icewtr/DraftONE/Wiring/Draft wiring diagram.jpg

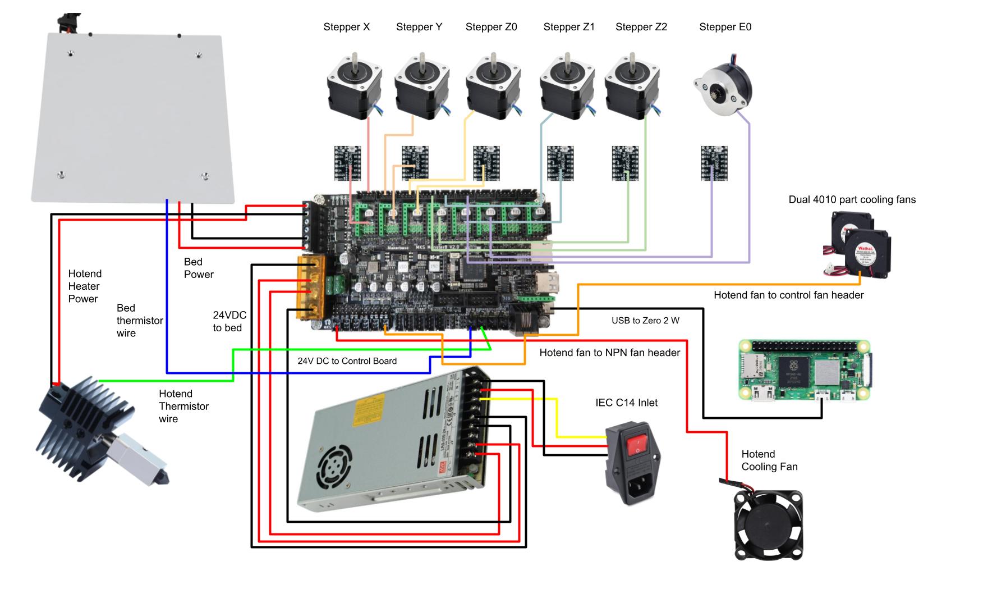
Wiring/Draft wiring diagram.jpg
