icewtr/DraftONE/README.md

# DraftONE
DraftONE is a modular 3D printer that does (a bit) more than your average printer.

image of draftONE
Another image ofDraftONE
image of VKTR

(if you're interested in the design process, check out my [Journal!](https://stardance.hackclub.com/projects/30695))
([Onshape Link Here!](https://cad.onshape.com/documents/799f14234b509065685c447c/w/a918fdbbd67d45ceec001d60/e/c847d4bcc65e06fd52b15de9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))

# Description
### So what exactly is this? 
- DraftONE is a heavy duty 3d printer style platform for manufacturing. It is built to be able to handle the loads of heavy manufacturing alongside the high accelerations and speeds of performance 3d printing, whilst being in a package similar to a 3D printer

- It was also built to be modular. Built with the Voron build style and package in mind, it is compatible with high-performance toolheads like the Voron Stealthburner or the Dragonburner. Also, the gantry was designed with a potential of milling and laser cutting in mind.

### What else did you make with it?

- Alongside this printer, I made the V.K.T.R toolhead - an ultra-lightweight, A4T-style toolhead that's smaller and cheaper than the original A4T and DragonBurner toolheads it was designed from. It was built to use the alreacy cheap hotend ecosystem of the Bambu Lab X1 Carbon, where you are able to get them for around 10-20 dollars each. This allowed me to prioritize the funds where it mattered, such as a better control board.

### Why did you make it?

SO basically, it started at Outpost/Opensauce. Seeing a friend of mine make a custom 3D printer looked so cool, and I couldn't imagine how cool it would have been to make your own 3d printer. Once I came back from outpost, I hit the ground running. I recall hopping onto CAD that morning, thinking up what I wanted to do with this 3D printer.

It was mainly aimed at solving one problem I've personally seen and believe that others have experienced: not being able to access good, cheap, manufacturing equipment. For example, in my FTC team, although we have a reliable 3D printer, our CNC was not nearly as reliable, and as a result, we stuck to getting others to manufacture parts for us, which added up costs really quickly. It brought me to the idea: what if I had a 3D printer thats focused to be a do-it-all machine? What if I focused it to be a good 3D printer, whilst making it a semi-capable milling machine for softer materials and routing? I felt like I was onto something, and started. 

Originally this design had a lot of ambition. I originally wanted a massive toolchanger, dual-hotend toolheads, and many more out-of-scope ideas. After a harsh reality check after realizing whatever I made in my V1 printer was really unoptimized, I took a step back and adjusted the scope. Instead of making it a toolchanger or anything like that, I just made a simple, modular design that will suit more needs than my original overscoped idea.

And then. it evolved into what is currently DraftONE, a sleek and industrial-looking, yet powerful heavy duty machine made for more than just 3D printing. This personally was a wild ride for me, and I hope you'll like this.

### What sort of feedback did you get and implement?

Over the course of this project, I got a lot of feedback from lots of people, and it helped me in various ways. Back when I was at my original V1 printer, I received feedback (for example, in 3dp-circlework) about how, in trying to make this over-scoped design, I neglected the fundamentals in this 3D printer, which would cause issues such as toolhead flex and loss of rigidity. Alongside that, I also realized that my original "double-decker" toolhead idea wouldn't work as a result of the backpressure in the ducting, and I got a reference to the A4T-style toolhead structure, which inspired the VKTR. This feedback session made me realize that although I was progressing, I was progressing the wrong way, and in the long run, it'd be better to step back and restart with solid fundamentals rather than hope it works.

## so without further ado, let me introduce you to DraftONE!

# Technical Specs at a glance

- CoreXY kinematics system, using 6mm fiberglass GT2 Timing belts

- Nema17 x 40mm (42 N*cm) stepper motors for all motion-related applications

- Pancake nema14 * 17mm (10 N*cm) stepper motor for V.K.T.R. Extruder

- 220mm X * 220mm Y * 195mm Z Buildspace, similar to an ender3 (both large enough for most applications yet cheap enough)

- Raspberry Pi Zero 2 W plus Makerbase MKS Monster8 Control board system with combined TMC2209 and a4988 drivers

- Mean Well 350-Watt Power supply

- Using manual Paper levelling as a trustworthy, zero-BS levelling method (very cheap and reliable)

# BOM: Parts

### This is the parts needed for this printer! 

|Part |Description |Link |Quantity |Cost Per Unit (USD)|# Units Needed|Total Cost|
|---|---|---|---|---|---|---|
|MKS Monster8 V2 |Control Board |https://www.aliexpress.us/item/3256808836544913.html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 |1 |40.69 |1 |40.69 |
|Raspberry pi 0 2 W |Klipper Board |https://www.amazon.com/Raspberry-Zero-Bluetooth-RPi-2W/dp/B09LH5SBPS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 |1 |76.91 |1 |76.91 |
|tmc2209 6 pack |stepper drivers |https://www.amazon.com/dp/B08WZFK9KT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 |6 |29.99 |1 |29.99 |
|350w 24v psu |power supply |https://www.amazon.com/MEAN-WELL-LRS-350-24-350-4W-Switchable/dp/B013ETVO12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 |1 |29.49 |1 |29.49 |
|Nema17x40 |Nema17 Motion Motors |https://twotrees3d.com/products/nema-17-stepper-motor-5pcs-17hs4401-nema17-42-motor-4-lead-42bygh-1-5a-with-dupont-line-for-3d-printer-and-cnc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 |5 |39 |1 |39 |
|nema14x17 |extruder |https://www.amazon.com/STEPPERINLINE-VORON-Bipolar-0-9deg-%CE%A636x17-5mm/dp/B0B93F6KT2?ref_=ast_sto_dp |1 |18.99 |1 |18.99 |
|ender3 bed |heatbed |https://www.amazon.com/Ender-V2-Heated-Bed-Replacement/dp/B08VHTW8CQ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 |1 |21.59 |1 |21.59 |
|P1S Hotend |Bambu Lab Hotend |https://www.aliexpress.us/item/3256809472704213.html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 |1 |9.74 |1 |9.74 |
|BMG Gears |Extruder gears |https://www.aliexpress.us/item/3256807729482253.html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 |1 |6.2 |1 |6.2 |
|MGN12H 300M Linear rail |X rails |https://www.aliexpress.us/item/3256812569138716.html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 |1 |15.89 |1 |15.89 |
|MGN12H 350mm rail |Y rails |https://www.aliexpress.us/item/3256812894885025.html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 |1 |13.09 |2 |26.18 |
|10m 3030 extrusion |extrusion frame |https://www.amazon.com/NETRCRHOM-Aluminum-Extrusion-European-Standard/dp/B0C9WGJNR9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 |10*1000mm|130 |1 |130 |
|4010 blowers |part cooling |https://www.amazon.com/GBA-SZC-Bearing-Brushless-Printers-Cooling/dp/B0FSZC6VPF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 |2 |14.98 |1 |14.98 |
|3007 blower |exhaust hotend |https://www.amazon.com/MECCANIXITY-3007-Small-Plastic-Cooling/dp/B0GTBM64CG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 |1 |9.02 |1 |9.02 |
|5mm-8mm coupler |for Z axis |https://www.aliexpress.us/item/3256811645171099.html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 |1 |4.82 |3 |14.46 |
|Linear rods, 10MM OD m5 threaded|linear rods, cut to 275mm |https://www.amazon.com/300mm-Chrome-Plated-Linear-Socket/dp/B0BM5LSG35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 |2 |13.99 |1 |13.99 |
|Ender 3 bed screws + levelling  |alternate to auto levelling |https://www.aliexpress.us/item/3256803219034244.html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 |1 |7.39 |1 |7.39 |
|Leadscrew |comes with pattern nut asw |https://www.aliexpress.us/item/3256805576723890.html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 |2 |10.39 |2 |20.78 |
|idler bearings |40 pack of bearings meant for the idlers|https://www.aliexpress.us/item/3256807812228542.html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 |40 |14.41 |1 |14.41 |
|drive pulleys |12mm long for extra tolerance to shifts |https://www.aliexpress.us/item/2251832836965041.html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 |2 |6.4 |1 |6.4 |
|T nuts |attaching to extrusion |https://www.aliexpress.us/item/3256803517041420.html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 |100 |18.95 |2 |37.9 |
|M4 D5 35mm L shoulder screws |holds idlers |https://www.aliexpress.us/item/3256804179391501.html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 |5 |3.88 |2 |7.76 |
|GT2 Open belt, 2m long |Motion belt |https://www.aliexpress.us/item/3256809295236268.html?src=google&gatewayAdapt=glo2usa |1 |5.61 |1 |5.61 |
|Heatset insert M3 |for toolhead/bed/whatever |https://www.aliexpress.us/item/3256808837364843.html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 |1 |4.4 |1 |4.4 |
|IEC C14 Module |AC Inlet |https://www.amazon.com/EPLZON-Module-Printer-switch10A-Extension/dp/B09DRLYD2Z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 |1 |7.99 |1 |7.99 |
|PTFE Tubing |between extruder and hotend |https://www.amazon.com/Creality-Teflon-Tube-Kit-1M/dp/B0CTSDP56S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 |1 |6.99 |1 |6.99 |
|LM10UU |guide rods for z axis |https://www.aliexpress.us/item/2261800217287389.html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 |2 |3.94 |1 |3.94 |
|2510 axial fan |hotend cooling |https://www.aliexpress.us/item/3256807411995377.html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 |1 |5.48 |1 |5.48 |
|M4 screw kit |bed, gantry |https://www.amazon.com/Fgruh-750PCS-Assortment-Washers-Assorted/dp/B0FG2D92BV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 |1 |9.99 |1 |9.99 |
|M3 screw kit |toolhead, framing, and other stuff |https://www.amazon.com/Fgruh-750PCS-Assortment-Washers-Assorted/dp/B0FGV5FCBN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 |1 |9.99 |1 |9.99 |
|M2.5 screw kit |for toolhead |https://www.amazon.com/VGBUY-1001Pcs-Screws-4-20mm-Assortment/dp/B0FJ1YMG3J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 |1 |8.99 |1 |8.99 |
|Heatset insert kit m2-m4 |for toolhead/bed/whatever |https://www.amazon.com/Threaded-Inserts-Printing-Hardware-Soldering/dp/B0GYD133M5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 |1 |9.99 |1 |9.99 |
|SD card |for Klipper + prints |https://www.amazon.com/Patriot-Micro-Flash-Memory-Card/dp/B08KSTKGVX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 |1 |9.99 |1 |9.99 |
|XH2 Cable |for steppers |https://www.amazon.com/Alinan-Double-Ended-Terminal-4pin-6pin-Extension/dp/B09PZXJJ2N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|1 |10.99 |1 |10.99 |
|22awg wire |for other power stuff |https://www.amazon.com/BNTECHGO-Silicone-Flexible-Strands-Stranded/dp/B07HGT44XY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 |1 |11.48 |1 |11.48 |
|M3*12 Screws |For Printer Superstructure |https://www.mcmaster.com/91290A500/ |100 |5.87 |2 |11.74 |
|PEI Sheet plus magnet base |actual bed surface |https://www.amazon.com/Creality-Removable-Flexible-Magnetic-235x235mm/dp/B082PFL8TX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 |1 |12.99 |1 |12.99 |
| | | | | | | |
|TOTAL COST | | | | | |722.32 |

# Procurement BOM

### basically the parts Im seeking funding for!
|Part |Description |Link |Quantity |Cost Per Unit (USD)|# Units Needed|Total Cost|
|---|---|---|---|---|---|---|
|MKS Monster8 V2 |Control Board |https://www.aliexpress.us/item/3256808836544913.html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 |1 |40.69 |1 |40.69 |
|tmc2209 6 pack |stepper drivers |https://www.amazon.com/dp/B08WZFK9KT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 |6 |29.99 |1 |29.99 |
|350w 24v psu |power supply |https://www.amazon.com/MEAN-WELL-LRS-350-24-350-4W-Switchable/dp/B013ETVO12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 |1 |29.49 |1 |29.49 |
|Nema17x40 |Nema17 Motion Motors |https://twotrees3d.com/products/nema-17-stepper-motor-5pcs-17hs4401-nema17-42-motor-4-lead-42bygh-1-5a-with-dupont-line-for-3d-printer-and-cnc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 |5 |39 |1 |39 |
|nema14x17 |extruder |https://www.amazon.com/STEPPERINLINE-VORON-Bipolar-0-9deg-%CE%A636x17-5mm/dp/B0B93F6KT2?ref_=ast_sto_dp |1 |18.99 |1 |18.99 |
|ender3 bed |heatbed |https://www.amazon.com/Ender-V2-Heated-Bed-Replacement/dp/B08VHTW8CQ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 |1 |21.59 |1 |21.59 |
|P1S Hotend |Bambu Lab Hotend |https://www.aliexpress.us/item/3256809472704213.html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 |1 |9.74 |1 |9.74 |
|BMG Gears |Extruder gears |https://www.aliexpress.us/item/3256807729482253.html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 |1 |6.2 |1 |6.2 |
|MGN12H 300M Linear rail |X rails |https://www.aliexpress.us/item/3256812569138716.html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 |1 |15.89 |1 |15.89 |
|MGN12H 350mm rail |Y rails |https://www.aliexpress.us/item/3256812894885025.html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 |1 |13.09 |2 |26.18 |
|10m 3030 extrusion |extrusion frame |https://www.amazon.com/NETRCRHOM-Aluminum-Extrusion-European-Standard/dp/B0C9WGJNR9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 |10*1000mm|130 |1 |130 |
|4010 blowers |part cooling |https://www.amazon.com/GBA-SZC-Bearing-Brushless-Printers-Cooling/dp/B0FSZC6VPF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 |2 |14.98 |1 |14.98 |
|3007 blower |exhaust hotend |https://www.aliexpress.us/item/3256808061437403.html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 |1 |5.69 |1 |5.69 |
|5mm-8mm coupler |for Z axis |https://www.aliexpress.us/item/3256811645171099.html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|1 |4.82 |3 |14.46 |
|Linear rods, 10MM OD m5 threaded|linear rods, cut to 275mm |https://www.amazon.com/300mm-Chrome-Plated-Linear-Socket/dp/B0BM5LSG35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 |2 |13.99 |1 |13.99 |
|Ender 3 bed screws + levelling  |alternate to auto levelling |https://www.aliexpress.us/item/3256803219034244.html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 |1 |7.39 |1 |7.39 |
|Leadscrew |comes with pattern nut asw |https://www.aliexpress.us/item/3256805576723890.html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 |2 |10.39 |2 |20.78 |
|idler bearings |40 pack of bearings meant for the idlers|https://www.aliexpress.us/item/3256807812228542.html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 |40 |14.41 |1 |14.41 |
|drive pulleys |12mm long for extra tolerance to shifts |https://www.aliexpress.us/item/2251832836965041.html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 |2 |6.4 |1 |6.4 |
|T nuts |attaching to extrusion |https://www.aliexpress.us/item/3256803517041420.html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 |100 |18.95 |2 |37.9 |
|M4 D5 35mm L shoulder screws |holds idlers |https://www.aliexpress.us/item/3256804179391501.html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 |5 |3.88 |2 |7.76 |
|GT2 Open belt, 2m long |Motion belt |https://www.aliexpress.us/item/3256809295236268.html?src=google&gatewayAdapt=glo2usa |1 |5.61 |1 |5.61 |
|Heatset insert M3 |for toolhead/bed/whatever |https://www.aliexpress.us/item/3256808837364843.html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 |1 |4.4 |1 |4.4 |
|IEC C14 Module |AC Inlet |https://www.amazon.com/EPLZON-Module-Printer-switch10A-Extension/dp/B09DRLYD2Z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 |1 |7.99 |1 |7.99 |
|PTFE Tubing |between extruder and hotend |https://www.amazon.com/Creality-Teflon-Tube-Kit-1M/dp/B0CTSDP56S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 |1 |6.99 |1 |6.99 |
|LM10UU |guide rods for z axis |https://www.aliexpress.us/item/2261800217287389.html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 |2 |3.94 |1 |3.94 |
|2510 axial fan |hotend cooling |https://www.aliexpress.us/item/3256807411995377.html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 |1 |5.48 |1 |5.48 |
|M4 screw kit |bed, gantry |https://www.amazon.com/Fgruh-750PCS-Assortment-Washers-Assorted/dp/B0FG2D92BV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 |1 |9.99 |1 |9.99 |
|M3 screw kit |toolhead, framing, and other stuff |https://www.amazon.com/Fgruh-750PCS-Assortment-Washers-Assorted/dp/B0FGV5FCBN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 |1 |9.99 |1 |9.99 |
|M2.5 screw kit |for toolhead |https://www.amazon.com/VGBUY-1001Pcs-Screws-4-20mm-Assortment/dp/B0FJ1YMG3J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 |1 |8.99 |1 |8.99 |
|Heatset insert kit m2-m4 |for toolhead/bed/whatever |https://www.amazon.com/Threaded-Inserts-Printing-Hardware-Soldering/dp/B0GYD133M5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 |1 |9.99 |1 |9.99 |
|PEI Sheet plus magnet base |actual bed surface |https://www.amazon.com/Creality-Removable-Flexible-Magnetic-235x235mm/dp/B082PFL8TX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 |1 |12.99 |1 |12.99 |
|TOTAL COST | | | | | |597.88 |

# Wiring Diagram
(no it doesnt wire itself sadly)

Follow this wiring diagram. make sure your diag jumpers are set (cuz sensorless homing) and you change your control fan headers to your fan voltage. usually theyre 24v so should be fine for all 24v bldc fans.

# Assembly guide

This thinng's wayyyyy tooo big to actually write a detailled wiring guide, but I'll give you the basics:

1. Install heatset inserts wherever applicable

2. Start by building the toolhead

3. Assemble the Gantry

4. Install toolhead on Gantry

5. Asselble the printbed assembly

6. Assemble Frame (DO NOT INSTALL ENCLOSURE PANELS)

7. install printbed by tramming leadscrews

8. Install gantry

9. Install CoreXY hardware

10. Install Electronics

## So that's it on DraftONE, Thank you so much for actually reading through this and have fun!!!
Made by Saharsh Nair, hopefully funded by Hack Club <3
