icewtr/DraftONE/firmware/README.md

# README: Firmware Edition

so basically this is where i need to put a special something :)

# DISCLAIMER. THIS PRINTER USES THE KLIPPER OPEN SOURCE FIRMWARE. THE ONLY FILES INCLUDED IN THE CONFIG FOLDER ARE CONFIGURATION FILES SPECIFIC TO THIS 3D PRINTER AND ITS OWN QUIRKS. I DID NOT INCLUDE THE ENTIRE KLIPPER FIRMWARE BECAUSE I FOUND IT REDUNDANT TO FORM AN ALREADY OPEN SOURCE REPO SINCE I AM NOT EVEN CHANGING ANYTHING.

# DISCLAIMER 2. THE TUNING VALUES FOR THIS PRINTER SHOULD BE TAKEN WITH A GRAIN OF SALT. THEY ARE TEST VALUES AND NOT REAL. THIS PRINTER HAS NOT BEEN BUILT YET SO NONE OF THESE TUNING VALUES ARE CORRECT, JUST AN ESTIMATED GUESS.
