icewtr/DraftONE/BOM_Parts .csv

Part | Description | Link | Quantity | Cost Per Unit (USD) | # Units Needed | Total Cost
MKS Monster8 V2 | Control Board | https://www.aliexpress.us/item/3256808836544913.html?curPageLogUid=jvy4XZYRYQTU | 1 | 40.69 | 1 | 40.69
Raspberry pi 0 2 W | Klipper Board | https://www.amazon.com/Raspberry-Zero-Bluetooth-RPi-2W/dp/B09LH5SBPS | 1 | 76.91 | 1 | 76.91
tmc2209 6 pack | stepper drivers | https://www.amazon.com/dp/B08WZFK9KT?lv=shuf&channelId=500&plpRedirect=mhFallback | 5 | 29.99 | 1 | 29.99
350w 24v psu | power supply | https://www.amazon.com/MEAN-WELL-LRS-350-24-350-4W-Switchable/dp/B013ETVO12 | 1 | 29.49 | 1 | 29.49
Nema17x40 | Nema17 Motion Motors | https://twotrees3d.com/products/nema-17-stepper-motor-5pcs-17hs4401-nema17-42-motor-4-lead-42bygh-1-5a-with-dupont-line-for-3d-printer-and-cnc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 | 5 | 39 | 1 | 39
nema14x17 | extruder | https://www.amazon.com/STEPPERINLINE-VORON-Bipolar-0-9deg-%CE%A636x17-5mm/dp/B0B93F6KT2 | 1 | 18.99 | 1 | 18.99
ender3 bed | heatbed | https://www.amazon.com/Ender-V2-Heated-Bed-Replacement/dp/B08VHTW8CQ | 1 | 21.59 | 1 | 21.59
P1S Hotend | Bambu Lab Hotend | https://www.aliexpress.us/item/3256809472704213.html?curPageLogUid=cB17nEgkUGsN | 1 | 9.74 | 1 | 9.74
BMG Gears | Extruder gears | https://www.aliexpress.us/item/3256807729482253.html?curPageLogUid=1SnX7z4nzGrF | 1 | 6.2 | 1 | 6.2
MGN12H 300M Linear rail | X rails | https://www.aliexpress.us/item/3256812569138716.html?curPageLogUid=am6J7UNayy8z | 1 | 15.89 | 1 | 15.89
MGN12H 350mm rail | Y rails | https://www.aliexpress.us/item/3256812894885025.html?curPageLogUid=DqyHSvN2WorU | 1 | 13.09 | 2 | 26.18
10m 3030 extrusion | extrusion frame | https://www.amazon.com/NETRCRHOM-Aluminum-Extrusion-European-Standard/dp/B0C9WGJNR9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 | 10*1000mm | 130 | 1 | 130
4010 blowers | part cooling | https://www.amazon.com/GBA-SZC-Bearing-Brushless-Printers-Cooling/dp/B0FSZC6VPF?sp_csd=d2lkZ2V0TmFtZT1zcF9hdGY | 2 | 14.98 | 1 | 14.98
3007 blower | exhaust hotend | https://www.amazon.com/MECCANIXITY-3007-Small-Plastic-Cooling/dp/B0GTBM64CG | 1 | 9.02 | 1 | 9.02
5mm-8mm coupler | for Z axis | https://www.aliexpress.us/item/3256811645171099.html?curPageLogUid=XTn84aQN0sb8 | 1 | 4.82 | 3 | 14.46
Linear rods, 10MM OD m5 threaded | linear rods, cut to 275mm | https://www.amazon.com/300mm-Chrome-Plated-Linear-Socket/dp/B0BM5LSG35 | 2 | 13.99 | 1 | 13.99
Ender 3 bed screws + levelling | alternate to auto levelling | https://www.aliexpress.us/item/3256803219034244.html?curPageLogUid=wMyzkiWWxTDY | 1 | 7.39 | 1 | 7.39
Leadscrew | comes with pattern nut asw | https://www.aliexpress.us/item/3256805576723890.html?curPageLogUid=w3Ev6MfdfxFK | 2 | 10.39 | 2 | 20.78
idler bearings | 40 pack of bearings meant for the idlers | https://www.aliexpress.us/item/3256807812228542.html?curPageLogUid=AFciNL5HmcUS | 40 | 14.41 | 1 | 14.41
drive pulleys | 12mm long for extra tolerance to shifts | https://www.aliexpress.us/item/2251832836965041.html?curPageLogUid=7LcTeNlqPBNF | 2 | 6.4 | 1 | 6.4
T nuts | attaching to extrusion | https://www.aliexpress.us/item/3256803517041420.html?curPageLogUid=WfM4ratPsYXY | 100 | 18.95 | 2 | 37.9
M4 D5 35mm L shoulder screws | holds idlers | https://www.aliexpress.us/item/3256804179391501.html?curPageLogUid=mEtEJ5ou3tlM | 5 | 3.88 | 2 | 7.76
GT2 Open belt, 2m long | Motion belt | https://www.aliexpress.us/item/3256809295236268.html?src=google&gatewayAdapt=glo2usa | 1 | 5.61 | 1 | 5.61
Heatset insert M3 | for toolhead/bed/whatever | https://www.aliexpress.us/item/3256808837364843.html?curPageLogUid=TXrTzOwp9yst | 1 | 4.4 | 1 | 4.4
IEC C14 Module | AC Inlet | https://www.amazon.com/EPLZON-Module-Printer-switch10A-Extension/dp/B09DRLYD2Z?cv_ct_cx=iec%2Bc14%2Bmodule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 | 1 | 7.99 | 1 | 7.99
PTFE Tubing | between extruder and hotend | https://www.amazon.com/Creality-Teflon-Tube-Kit-1M/dp/B0CTSDP56S?sp_csd=d2lkZ2V0TmFtZT1zcF9hdGY | 1 | 6.99 | 1 | 6.99
LM10UU | guide rods for z axis | https://www.aliexpress.us/item/2261800217287389.html?curPageLogUid=JKlKNRcYixCa | 2 | 3.94 | 1 | 3.94
2510 axial fan | hotend cooling | https://www.aliexpress.us/item/3256807411995377.html?curPageLogUid=LtTNNmSrac6O | 1 | 5.48 | 1 | 5.48
M4 screw kit | bed, gantry | https://www.amazon.com/Fgruh-750PCS-Assortment-Washers-Assorted/dp/B0FG2D92BV | 1 | 9.99 | 1 | 9.99
M3 screw kit | toolhead, framing, and other stuff | https://www.amazon.com/Fgruh-750PCS-Assortment-Washers-Assorted/dp/B0FGV5FCBN | 1 | 9.99 | 1 | 9.99
M2.5 screw kit | for toolhead | https://www.amazon.com/VGBUY-1001Pcs-Screws-4-20mm-Assortment/dp/B0FJ1YMG3J | 1 | 8.99 | 1 | 8.99
Heatset insert kit m2-m4 | for toolhead/bed/whatever | https://www.amazon.com/Threaded-Inserts-Printing-Hardware-Soldering/dp/B0GYD133M5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 | 1 | 9.99 | 1 | 9.99
SD card | for Klipper + prints | https://www.amazon.com/Patriot-Micro-Flash-Memory-Card/dp/B08KSTKGVX | 1 | 9.99 | 1 | 9.99
XH2 Cable | for steppers | https://www.amazon.com/Alinan-Double-Ended-Terminal-4pin-6pin-Extension/dp/B09PZXJJ2N?nsdOptOutParam=true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 | 1 | 10.99 | 1 | 10.99
22awg wire | for other power stuff | https://www.amazon.com/BNTECHGO-Silicone-Flexible-Strands-Stranded/dp/B07HGT44XY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 | 1 | 11.48 | 1 | 11.48
M3*12 Screws | For Printer Superstructure | https://www.mcmaster.com/91290A500/ | 100 | 5.87 | 2 | 11.74
PEI Sheet plus magnet base | actual bed surface | https://www.amazon.com/Creality-Removable-Flexible-Magnetic-235x235mm/dp/B082PFL8TX | 1 | 12.99 | 1 | 12.99
TOTAL COST |  |  |  |  |  | 722.32
