icewtr/DraftONE/CAD/STLs/Printer Assy - Gantry Idler Part B.stl

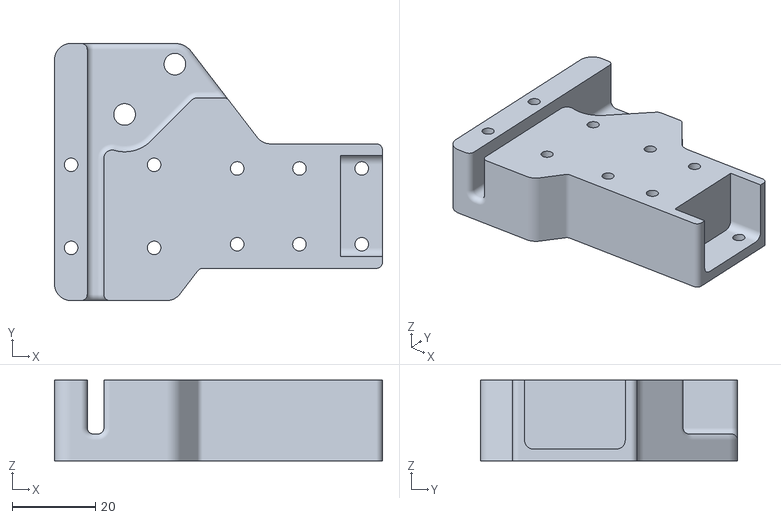
[picture p2: CAD file, 2026-10-21]
CAD/STLs/Printer Assy - Gantry Idler Part B.stl
79.0 x 61.9 x 19.5
