icewtr/DraftONE/CAD/STLs/Printer Assy - CoreXY Motor Part D.stl

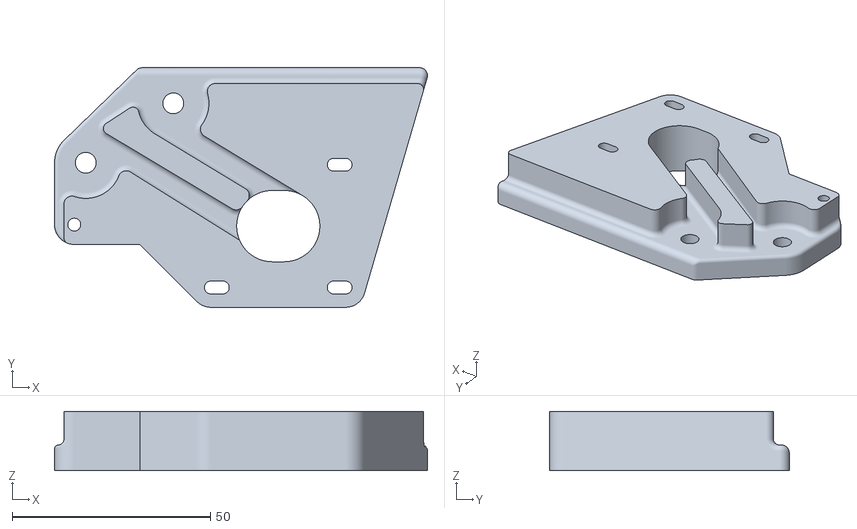
[picture p3: CAD file, 2026-10-21]
CAD/STLs/Printer Assy - CoreXY Motor Part D.stl
94.2 x 60.5 x 15.0
