icewtr/DraftONE/CAD/STLs/Printer Assy - Gantry Idler Part A.stl

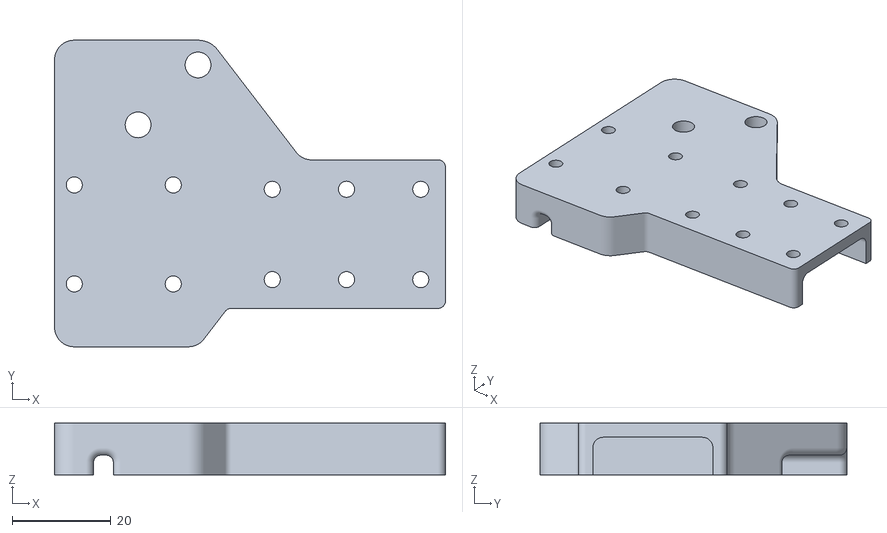
[picture p4: CAD file, 2026-10-21]
CAD/STLs/Printer Assy - Gantry Idler Part A.stl
79.0 x 61.9 x 10.5
