icewtr/DraftONE/CAD/STLs/Printer Assy - Bed Sandwich Bottom Plate.stl

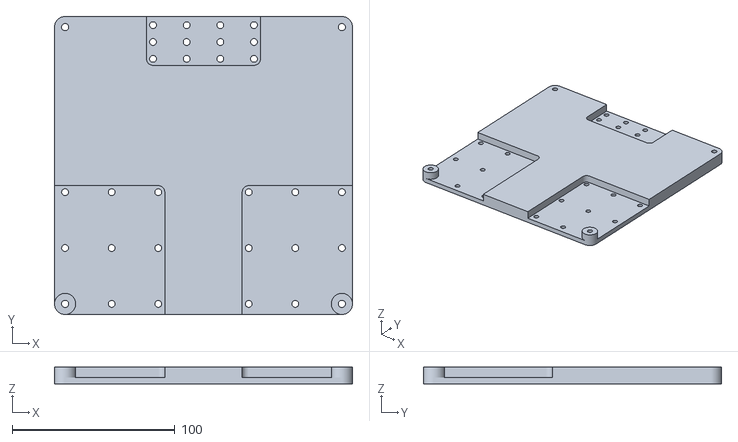
[picture p5: CAD file, 2026-10-21]
CAD/STLs/Printer Assy - Bed Sandwich Bottom Plate.stl
183.0 x 183.0 x 10.3
