icewtr/DraftONE/CAD/STLs/Printer Assy - Bed Sandwich Part A.stl

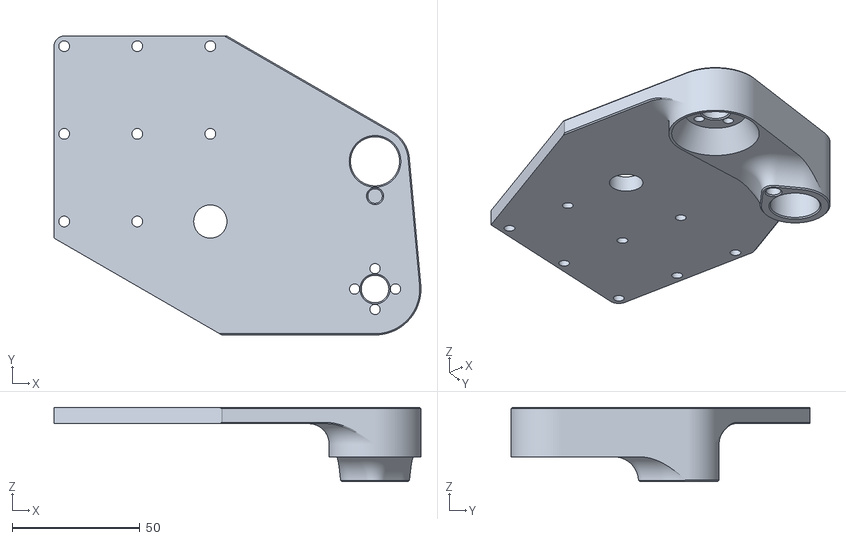
[picture p6: CAD file, 2026-10-21]
CAD/STLs/Printer Assy - Bed Sandwich Part A.stl
143.7 x 117.1 x 29.0
