icewtr/DraftONE/CAD/STLs/Printer Assy - Part 24.stl

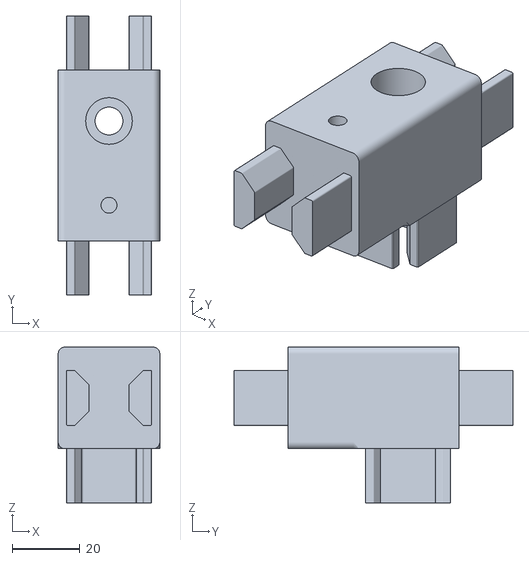
[picture p7: CAD file, 2026-10-21]
CAD/STLs/Printer Assy - Part 24.stl
30.0 x 82.4 x 46.0
