icewtr/DraftONE/CAD/STLs/Printer Assy - Corner Brace C.stl

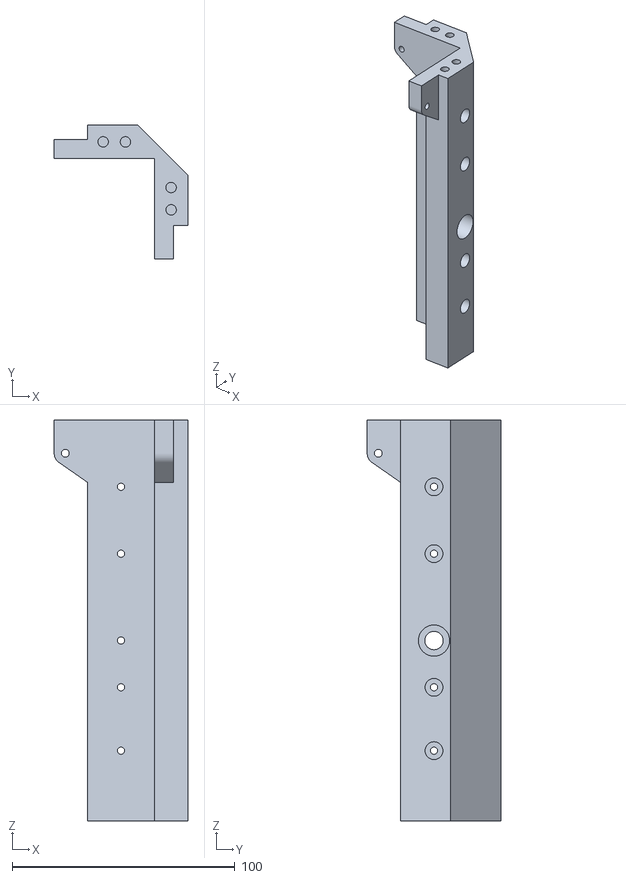
[picture p8: CAD file, 2026-10-21]
CAD/STLs/Printer Assy - Corner Brace C.stl
60.0 x 60.0 x 180.0
