icewtr/DraftONE/CAD/STLs/Printer Assy - Mounting Blank Plate.stl

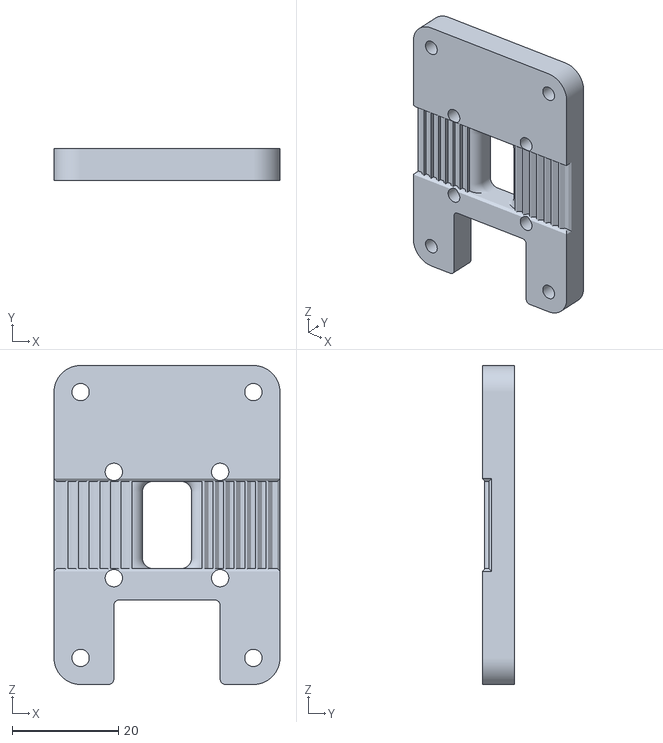
[picture p9: CAD file, 2026-10-21]
CAD/STLs/Printer Assy - Mounting Blank Plate.stl
42.5 x 6.00 x 60.0
