icewtr/DraftONE/CAD/STLs/Printer Assy - Z axis mount A.stl

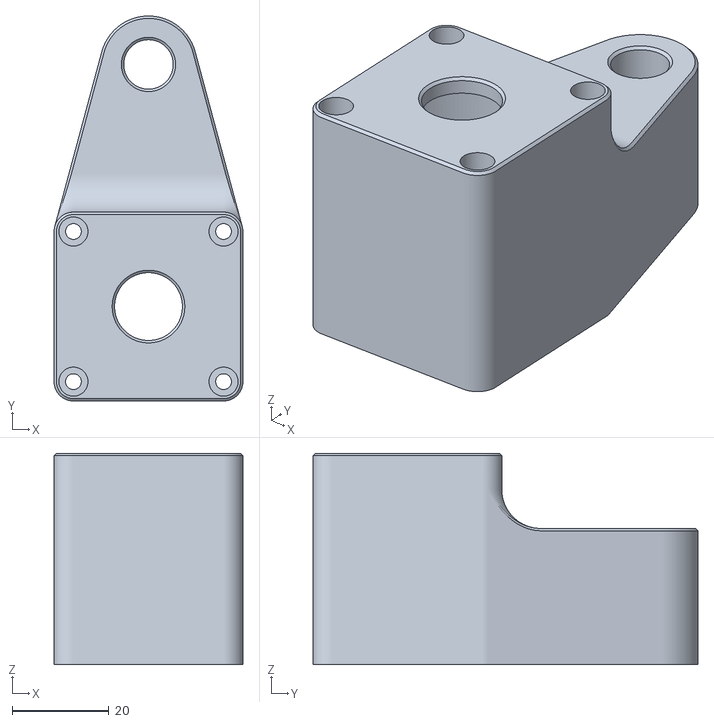
[picture p10: CAD file, 2026-10-21]
CAD/STLs/Printer Assy - Z axis mount A.stl
39.0 x 79.5 x 43.7
