icewtr/DraftONE/CAD/STLs/Printer Assy - Left Side Plate.stl

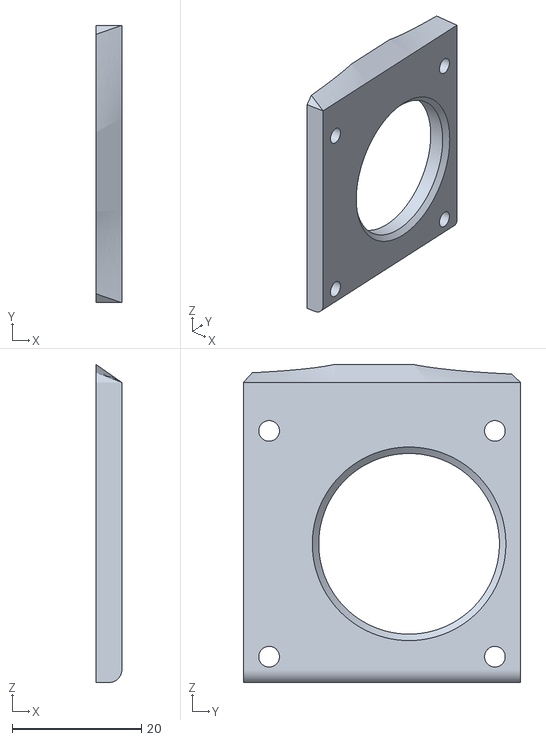
[picture p11: CAD file, 2026-10-21]
CAD/STLs/Printer Assy - Left Side Plate.stl
4.00 x 43.0 x 49.3
