icewtr/DraftONE/CAD/STLs/Printer Assy - CoreXY Idler Part D.stl

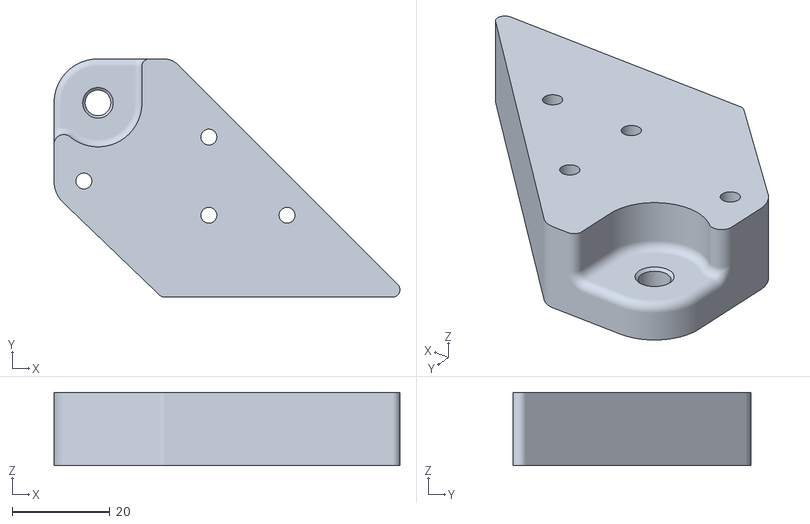
[picture p12: CAD file, 2026-10-21]
CAD/STLs/Printer Assy - CoreXY Idler Part D.stl
70.8 x 48.8 x 15.0
