icewtr/DraftONE/CAD/STLs/Printer Assy - Z axis mount B.stl

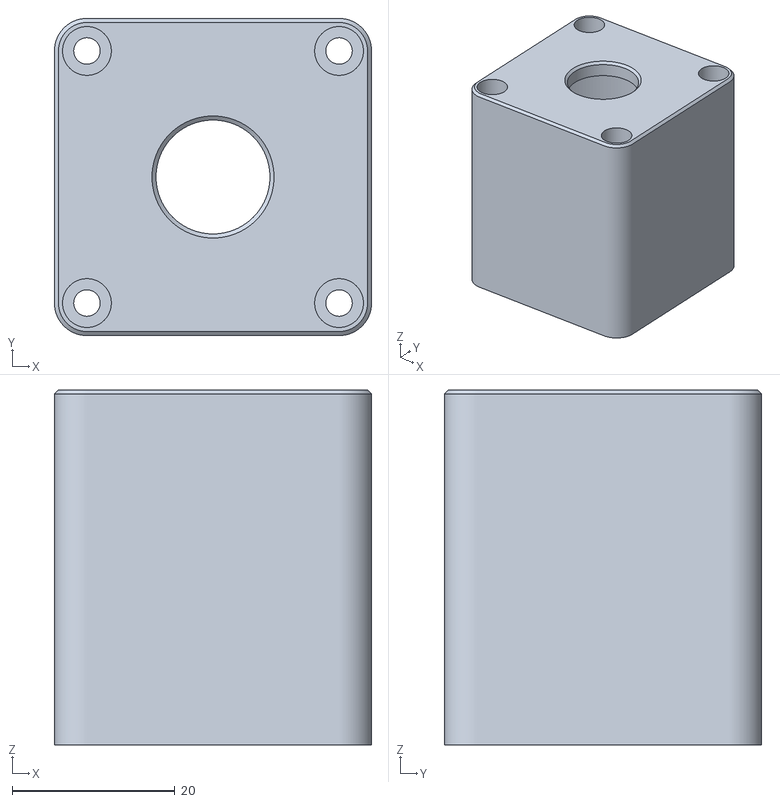
[picture p13: CAD file, 2026-10-21]
CAD/STLs/Printer Assy - Z axis mount B.stl
39.0 x 39.0 x 43.7
