icewtr/DraftONE/CAD/STLs/Printer Assy - Ducting Plate.stl

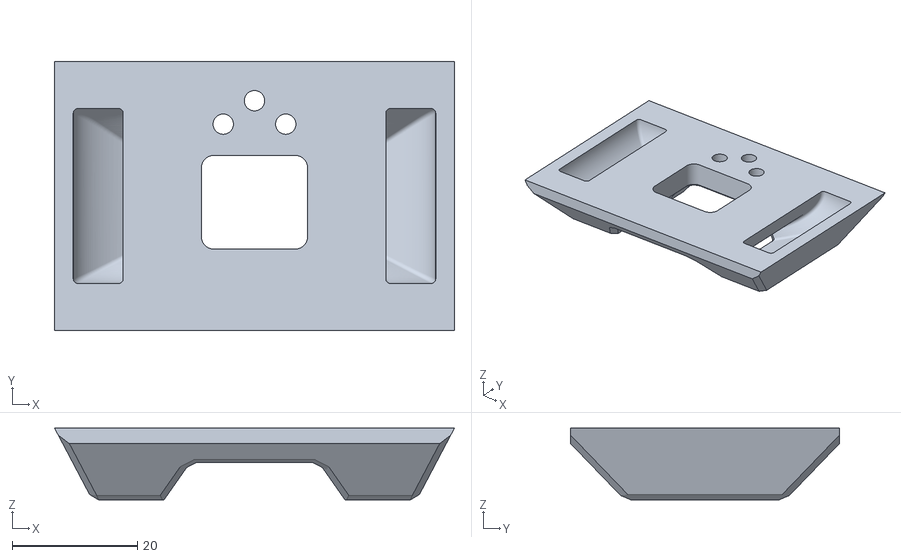
[picture p14: CAD file, 2026-10-21]
CAD/STLs/Printer Assy - Ducting Plate.stl
64.0 x 43.0 x 11.5
