icewtr/DraftONE/CAD/STLs/Printer Assy - Motor Plates-1__Body1.stl

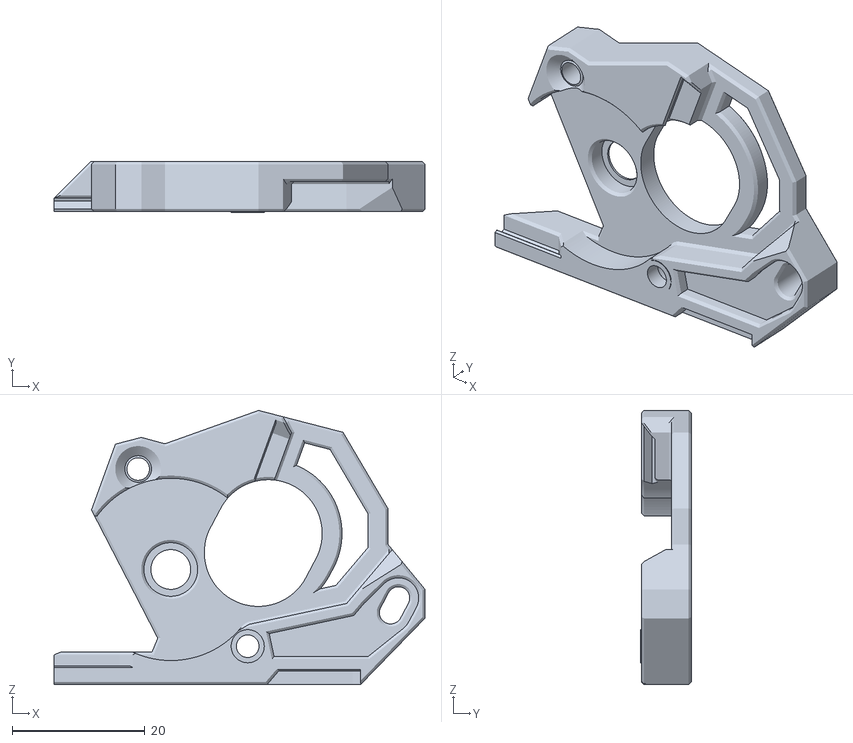
[picture p15: CAD file, 2026-10-21]
CAD/STLs/Printer Assy - Motor Plates-1__Body1.stl
56.0 x 7.65 x 41.4
