icewtr/DraftONE/CAD/STLs/Printer Assy - coreXY Idler spacer.stl

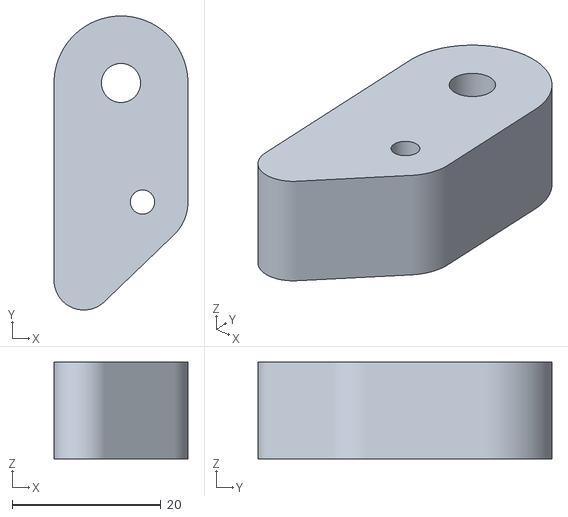
[picture p16: CAD file, 2026-10-21]
CAD/STLs/Printer Assy - coreXY Idler spacer.stl
18.0 x 39.5 x 13.0
