icewtr/DraftONE/CAD/STLs/Printer Assy - Corner Brace A.stl

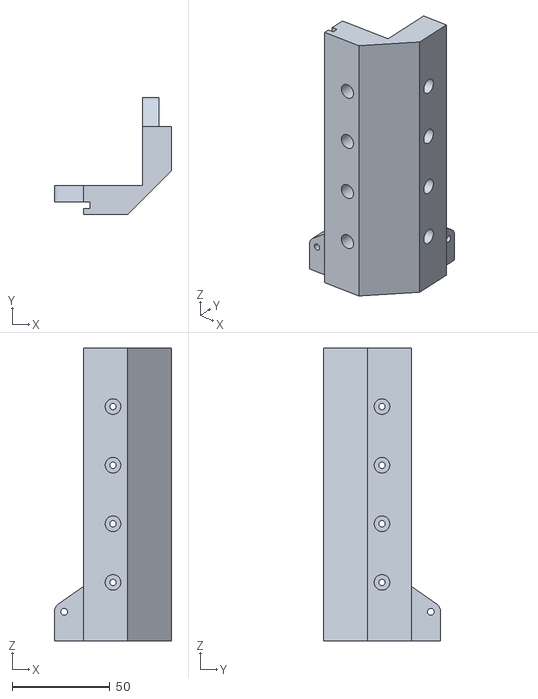
[picture p17: CAD file, 2026-10-21]
CAD/STLs/Printer Assy - Corner Brace A.stl
60.0 x 60.0 x 150.0
