icewtr/DraftONE/CAD/STLs/Printer Assy - Front Plate.stl

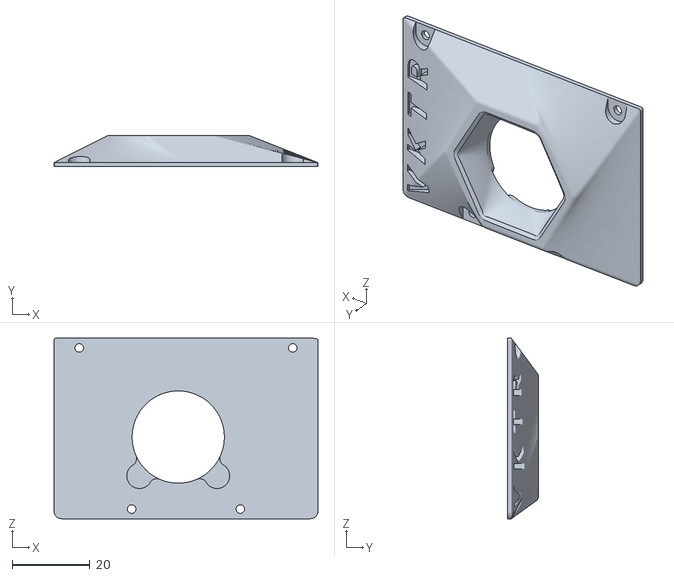
[picture p18: CAD file, 2026-10-21]
CAD/STLs/Printer Assy - Front Plate.stl
68.0 x 8.00 x 46.5
