icewtr/DraftONE/CAD/STLs/Printer Assy - Tension_Arm (1)-1__Body2.stl

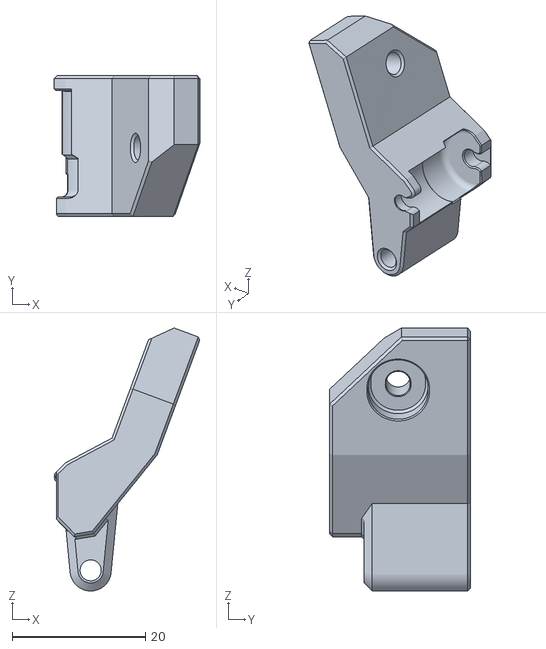
[picture p19: CAD file, 2026-10-21]
CAD/STLs/Printer Assy - Tension_Arm (1)-1__Body2.stl
21.8 x 21.1 x 39.5
