icewtr/DraftONE/CAD/STLs/Printer Assy - Endcap.stl

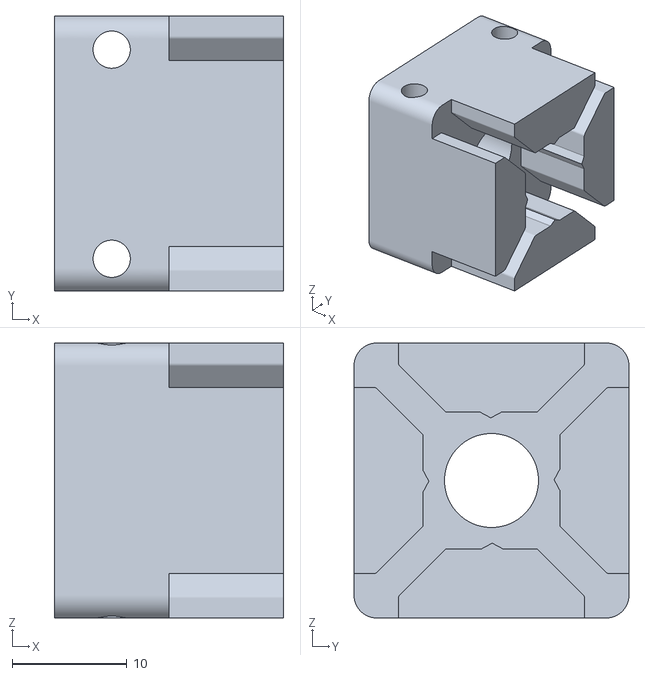
[picture p20: CAD file, 2026-10-21]
CAD/STLs/Printer Assy - Endcap.stl
20.0 x 24.0 x 24.0
