icewtr/DraftONE/CAD/STLs/Printer Assy - V.K.T.R. Body.stl

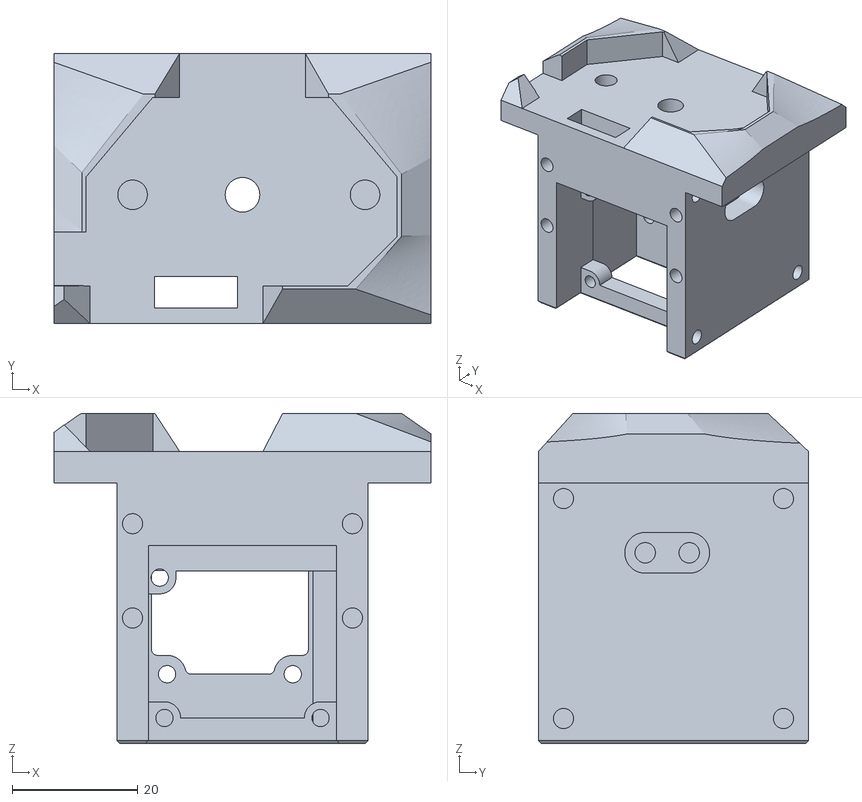
[picture p21: CAD file, 2026-10-21]
CAD/STLs/Printer Assy - V.K.T.R. Body.stl
60.0 x 43.0 x 52.6
