icewtr/DraftONE/CAD/STLs/Printer Assy - Bed Sandwich Top Plate.stl

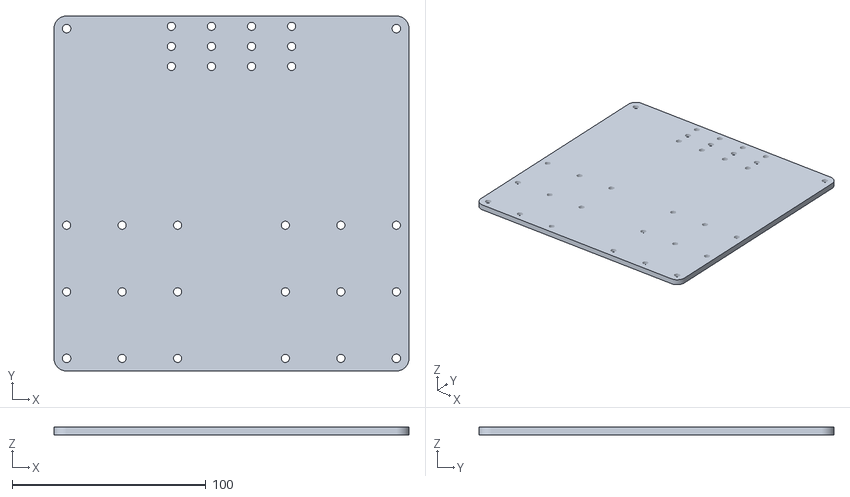
[picture p22: CAD file, 2026-10-21]
CAD/STLs/Printer Assy - Bed Sandwich Top Plate.stl
183.0 x 183.0 x 4.00
