icewtr/DraftONE/CAD/STLs/Printer Assy - Bed Sandwich Part B.stl

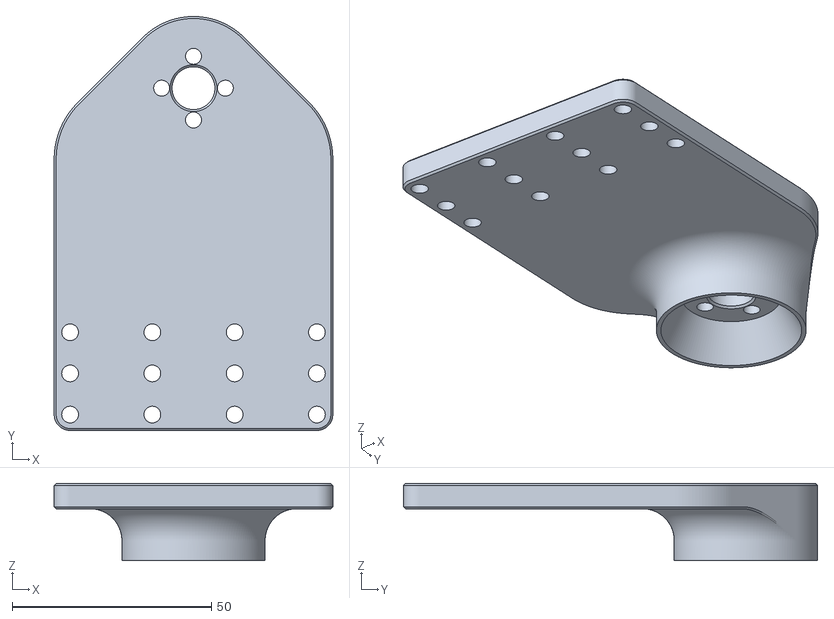
[picture p23: CAD file, 2026-10-21]
CAD/STLs/Printer Assy - Bed Sandwich Part B.stl
70.0 x 104.0 x 19.3
