icewtr/DraftONE/CAD/STLs/Printer Assy - Organic Mount.stl

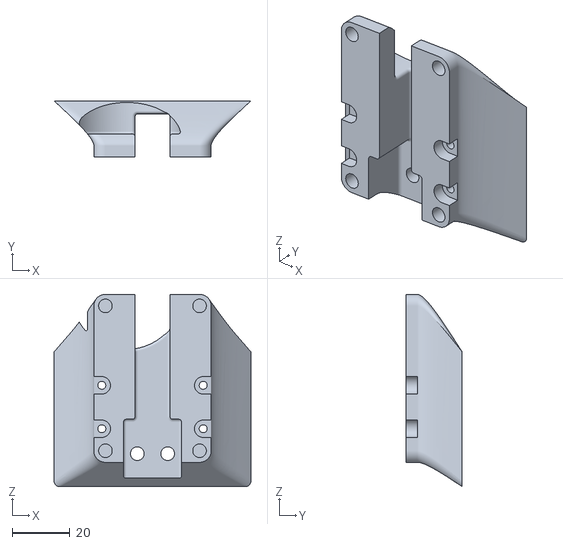
[picture p24: CAD file, 2026-10-21]
CAD/STLs/Printer Assy - Organic Mount.stl
68.0 x 19.5 x 66.4
