icewtr/DraftONE/CAD/STLs/Printer Assy - Corner Brace B.stl

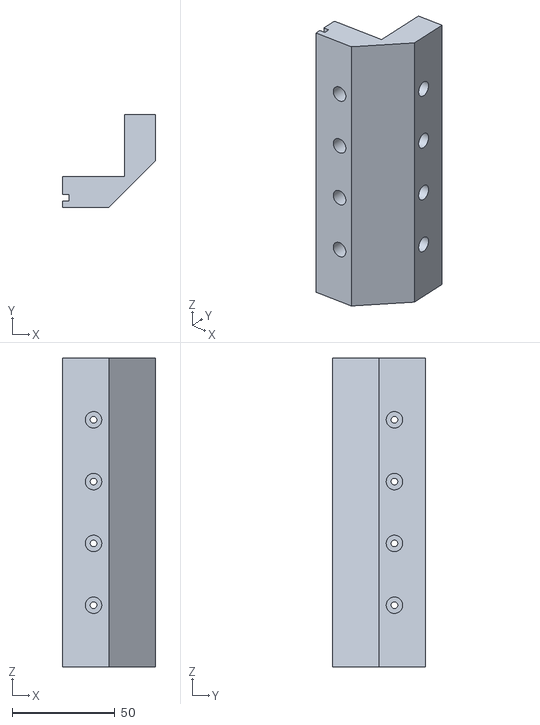
[picture p25: CAD file, 2026-10-21]
CAD/STLs/Printer Assy - Corner Brace B.stl
45.0 x 45.0 x 150.0
