icewtr/DraftONE/CAD/STLs/Printer Assy - Right Side Plate.stl

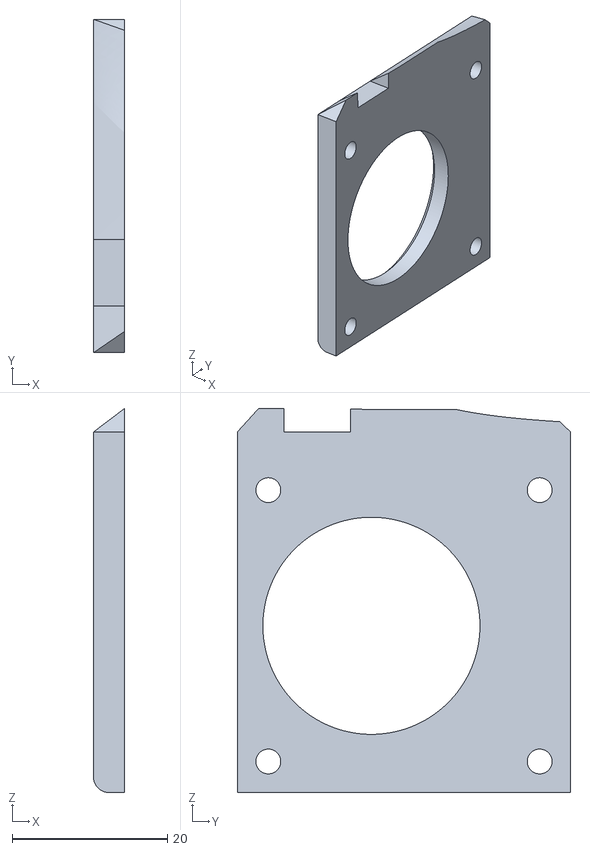
[picture p26: CAD file, 2026-10-21]
CAD/STLs/Printer Assy - Right Side Plate.stl
4.00 x 43.0 x 49.5
