icewtr/DraftONE/CAD/STLs/Printer Assy - CoreXY Motor Spacer.stl

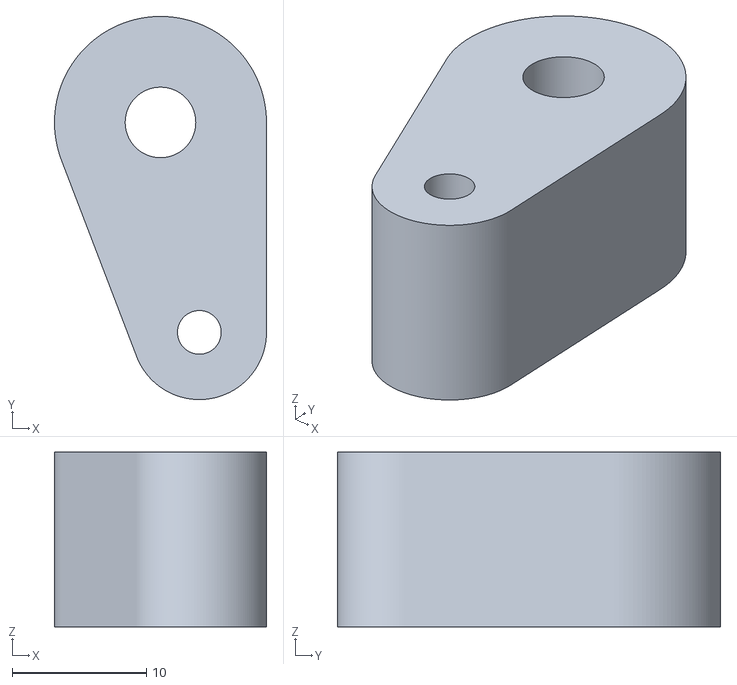
[picture p27: CAD file, 2026-10-21]
CAD/STLs/Printer Assy - CoreXY Motor Spacer.stl
15.8 x 28.5 x 13.0
