icewtr/DraftONE/CAD/STLs/Printer Assy - Main_Bodies-1__Body1.stl

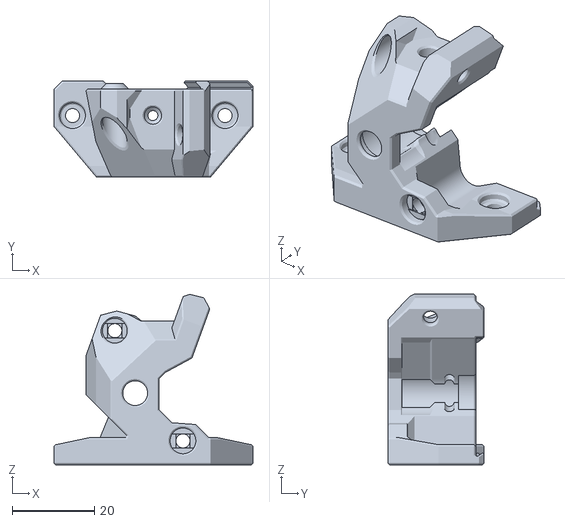
[picture p28: CAD file, 2026-10-21]
CAD/STLs/Printer Assy - Main_Bodies-1__Body1.stl
48.3 x 23.3 x 41.4
