icewtr/DraftONE/CAD/STLs/Printer Assy - Part 9.stl

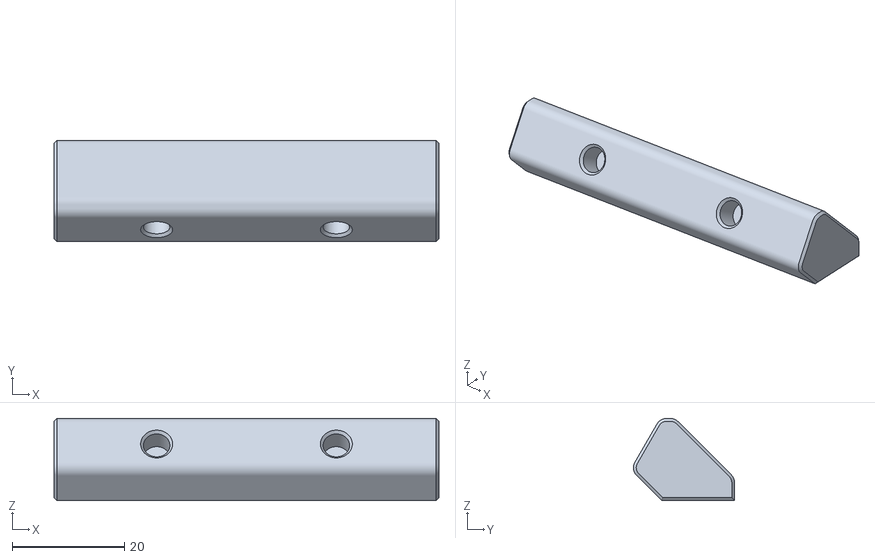
[picture p29: CAD file, 2026-10-21]
CAD/STLs/Printer Assy - Part 9.stl
68.6 x 18.0 x 14.6
