icewtr/DraftONE/(list of files, cad)

Other CAD files:
CAD/Printer Master Assembly.step
CAD/STLs/Printer Assy - Bed Sandwich Part C.stl
CAD/STLs/Printer Assy - CoreXY Idler Part A.stl
CAD/STLs/Printer Assy - CoreXY Motor Part A.stl
CAD/STLs/Printer Assy - CoreXY Idler Part C.stl
CAD/STLs/Printer Assy - Part 22.stl
CAD/STLs/Printer Assy - CoreXY Motor Part B.stl
CAD/STLs/Printer Assy - Gantry Idler Part C.stl
CAD/STLs/Printer Assy - CoreXY Motor Part C.stl
CAD/STLs/Printer Assy - CoreXY Idler Part B.stl
CAD/STLs/Printer Assy - Gantry Idler Part D.stl
CAD/STLs/Printer Assy - CoreXY Motor Spacer (1).stl
CAD/STLs/Printer Assy - Corner Brace A (1).stl
CAD/STLs/Printer Assy - Corner Brace A (2).stl
CAD/STLs/Printer Assy - Corner Brace A (3).stl
CAD/STLs/Printer Assy - Corner Brace B (1).stl
CAD/STLs/Printer Assy - Corner Brace B (2).stl
CAD/STLs/Printer Assy - Corner Brace B (3).stl
CAD/STLs/Printer Assy - Corner Brace C (1).stl
CAD/STLs/Printer Assy - Corner Brace C (2).stl
CAD/STLs/Printer Assy - Corner Brace C (3).stl
CAD/STLs/Printer Assy - Endcap (1).stl
CAD/STLs/Printer Assy - Z axis mount A (1).stl
CAD/STLs/Printer Assy - coreXY Idler spacer (1).stl
