icewtr/DraftONE/Images/PrinterRender.png

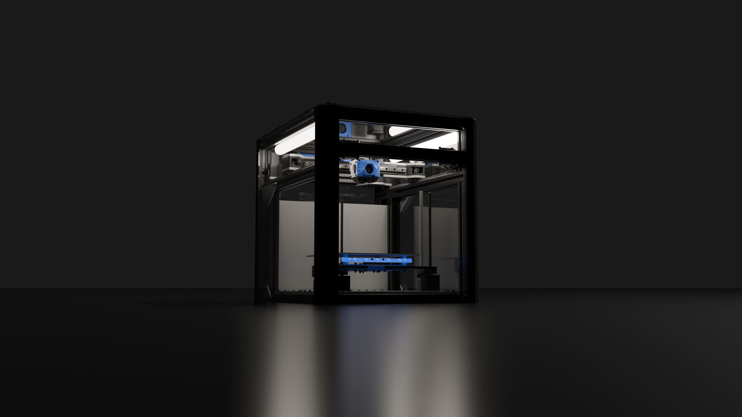
Images/PrinterRender.png
