icewtr/DraftONE/Images/PrinterWireframe.png

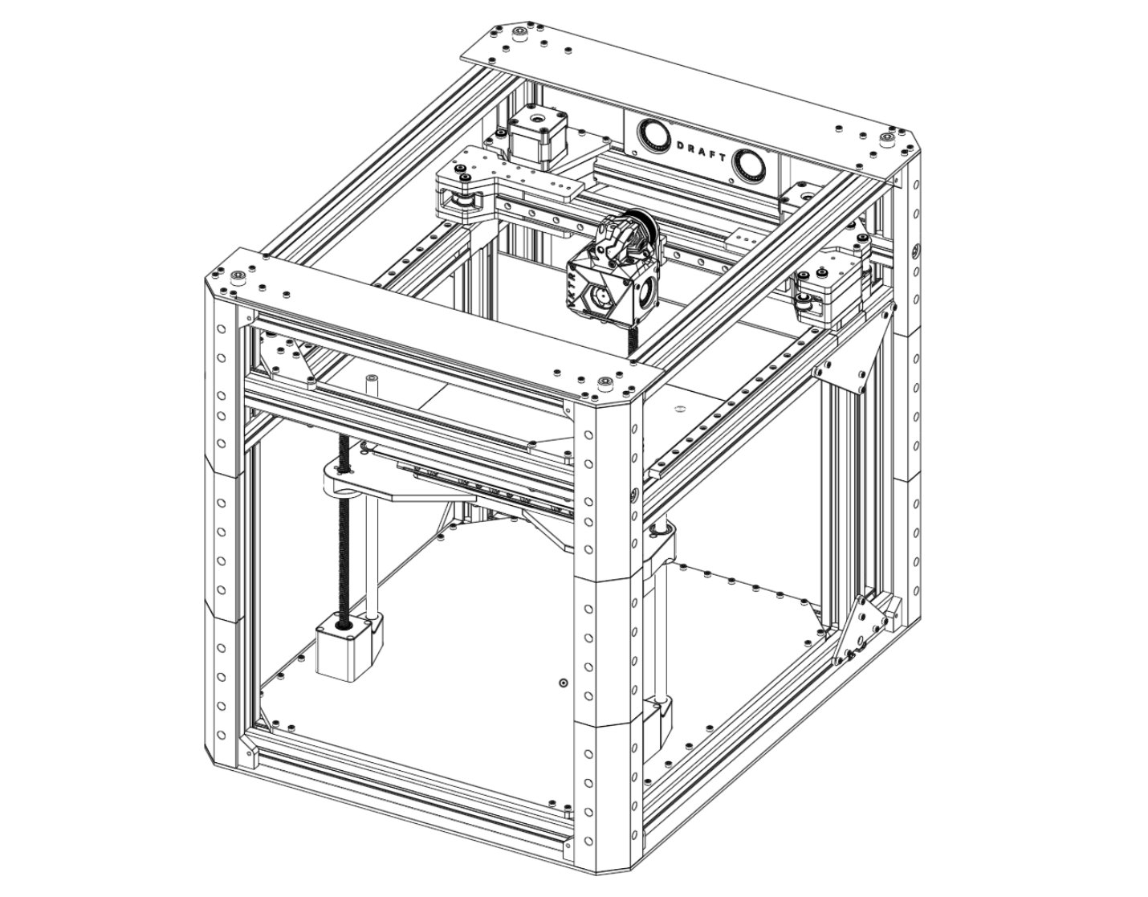
Images/PrinterWireframe.png
