icewtr/DraftONE/(commit log)

2026-10-20 starter printer.cfg
    a
    [printer.cfg]
2026-10-20 finished cfg files for printer :)
    [fluidd.cfg, macros.cfg, printer.cfg]
2026-10-20 added bom
2026-10-20 Add Procurement BOM
2026-10-20 add wiring diageam and assembly steps
2026-10-20 fix double folder issue
    [printer.cfg]
2026-10-20 added everything else i might be done
    [BOM_Parts .csv, BOM_Procurement .csv, Printer Assy.step]
2026-10-21 added all 3d printed files :)
    [BOM_Parts .csv, BOM_Procurement .csv, Printer Assy - Bed Sandwich Bottom Plate.stl, Printer Assy - Bed Sandwich Part A.stl, Printer Assy - Bed Sandwich Part B.stl, Printer Assy - Bed Sandwich Part C.stl, Printer Assy - Bed Sandwich Top Plate.stl, Printer Assy - CoreXY Idler Part A.stl]
2026-10-21 Update TMC2209 stepper driver quantity
